Basel-Shokha/Battery-Constrained-Maze-Runner/main.cpp

// ============================================================
//  main.cpp — High-Performance C++ Server Routing Backbone
// ============================================================
#include <iostream>
#include <fstream>
#include <string>
#include <sstream>
#include <set>
#include <thread>
#include <mutex>
#include "External Libraries/httplib.h"
#include "MazeSolver.h"

#ifdef _WIN32
  #include <winsock2.h>
  #include <ws2tcpip.h>
  #pragma comment(lib, "ws2_32.lib")
#else
  #include <sys/socket.h>
  #include <netinet/in.h>
  #include <arpa/inet.h>
  #include <unistd.h>
#endif

using nlohmann::json;
using namespace std;

std::string rawM5InstructionString = "START:1,0,0,8\n";
std::string latestMazeJson = "{}";
json globalTelemetryCache = {{"stepIdx",0},{"yaw",0.0},{"left",0},{"front",0},{"right",0},{"state","IDLE"}};
bool newMissionAvailable = false;
bool calibrationRequested = false;
bool resetRequested = false;
mutex telemetryMutex;

void printM5Packet(const std::string& packet) {
    std::cout << "\n========== PACKET SENT TO M5 ==========\n"
              << packet;
    if (packet.empty() || packet.back() != '\n') {
        std::cout << '\n';
    }
    std::cout << "=======================================\n" << std::flush;
}

void removeStartJourneyCommands() {
    std::stringstream input(rawM5InstructionString);
    std::stringstream output;
    std::string line;
    while (std::getline(input, line)) {
        if (line != "CMD:START_JOURNEY" && line != "CMD:ROUTE_ERROR") {
            output << line << "\n";
        }
    }
    rawM5InstructionString = output.str();
}

std::string getHeadingLabel(int dir) {
    if (dir == 0) return "NORTH";
    if (dir == 1) return "EAST";
    if (dir == 2) return "SOUTH";
    if (dir == 3) return "WEST";
    return "UNKNOWN";
}

int countOpenGrids(int startR, int startC, int direction, int maxRows, int maxCols, const json& wallsJson) {
    int openGrids = 0;
    int currR = startR; int currC = startC;
    auto hasWall = [&](int r1, int c1, int r2, int c2) {
        for (const auto& w : wallsJson) {
            if (!w.contains("between") || w["between"].size() < 2) continue;
            int cell1R = w["between"][0][0].get<int>();
            int cell1C = w["between"][0][1].get<int>();
            int cell2R = w["between"][1][0].get<int>();
            int cell2C = w["between"][1][1].get<int>();
            if (((cell1R == r1 && cell1C == c1) && (cell2R == r2 && cell2C == c2)) ||
                ((cell1R == r2 && cell1C == c2) && (cell2R == r1 && cell2C == c1))) {
                return true;
            }
        }
        return false;
    };
    while (true) {
        int nextR = currR; int nextC = currC;
        if      (direction == 0) nextR--;
        else if (direction == 1) nextC++;
        else if (direction == 2) nextR++;
        else if (direction == 3) nextC--;
        if (nextR < 0 || nextR >= maxRows || nextC < 0 || nextC >= maxCols) break;
        if (hasWall(currR, currC, nextR, nextC)) break;
        openGrids++;
        currR = nextR; currC = nextC;
    }
    return openGrids;
}

void udpTelemetryListener() {
#ifdef _WIN32
    WSADATA wsa;
    WSAStartup(MAKEWORD(2, 2), &wsa);
#endif
    int sock = socket(AF_INET, SOCK_DGRAM, 0);
    if (sock < 0) { cerr << "[UDP] socket creation failed\n"; return; }

    sockaddr_in addr{};
    addr.sin_family      = AF_INET;
    addr.sin_addr.s_addr = INADDR_ANY;
    addr.sin_port        = htons(8086);

    if (::bind(sock, (sockaddr*)&addr, sizeof(addr)) < 0) {
        cerr << "[UDP] bind failed on port 8086\n"; return;
    }
    cout << "[UDP] Telemetry listener bound on port 8086\n";

    char buffer[512];
    while (true) {
        int len = recvfrom(sock, buffer, sizeof(buffer) - 1, 0, nullptr, nullptr);
        if (len <= 0) continue;
        buffer[len] = '\0';
        try {
            json data = json::parse(buffer);
            lock_guard<mutex> lock(telemetryMutex);
            globalTelemetryCache["stepIdx"] = data["stepIdx"];
            globalTelemetryCache["yaw"]     = data["yaw"];
            globalTelemetryCache["left"]    = data["left"];
            globalTelemetryCache["front"]   = data["front"];
            globalTelemetryCache["right"]   = data["right"];
            globalTelemetryCache["state"]   = data["state"];
        } catch (...) {
            // malformed datagram, ignore and wait for the next one
        }
    }
}

int main() {
    httplib::Server svr;
    auto add_cors_headers = [](httplib::Response& res) {
        res.set_header("Access-Control-Allow-Origin",  "*");
        res.set_header("Access-Control-Allow-Methods", "POST, GET, OPTIONS");
        res.set_header("Access-Control-Allow-Headers", "Content-Type");
    };

    svr.Options("/send_maze",     [&](const httplib::Request&, httplib::Response& res) { add_cors_headers(res); res.status = 204; });
    svr.Options("/start_journey", [&](const httplib::Request&, httplib::Response& res) { add_cors_headers(res); res.status = 204; });
    svr.Options("/reset",         [&](const httplib::Request&, httplib::Response& res) { add_cors_headers(res); res.status = 204; });
    svr.Options("/notify_event",  [&](const httplib::Request&, httplib::Response& res) { add_cors_headers(res); res.status = 204; });
    svr.Options("/get_telemetry", [&](const httplib::Request&, httplib::Response& res) { add_cors_headers(res); res.status = 204; });
    svr.Options("/solve",         [&](const httplib::Request&, httplib::Response& res) { add_cors_headers(res); res.status = 204; });

    // ── ROUTE A: RECEIVE & BUILD STRUCT SOLUTION ────────────────────
    svr.Post("/send_maze", [&](const httplib::Request& req, httplib::Response& res) {
        add_cors_headers(res);
        try {
            json request = json::parse(req.body);
            std::string spawnDirStr = request["robot_direction"].get<std::string>();
            int initialSpawnDirectionInt = 1;
            if      (spawnDirStr == "north") initialSpawnDirectionInt = 0;
            else if (spawnDirStr == "south") initialSpawnDirectionInt = 2;
            else if (spawnDirStr == "west")  initialSpawnDirectionInt = 3;

            long long cap = request["config"]["battery_capacity"].get<long long>();
            int modeCode = 0; // 0 = CONSTRAINED, 1 = CONTINUOUS

            if (cap > 1000000) {
                modeCode = 1;
                cap = 8;
            }

            json path = json::array();

            // ── MANUAL ROUTE: follow the exact cells from the web UI, no solving ──
            if (request.contains("use_manual_route") && request["use_manual_route"].get<bool>()
                && request.contains("manual_route") && request["manual_route"].size() >= 2) {

                json route = request["manual_route"];
                for (int k = 0; k < route.size(); k++) {
                    json leg;
                    leg["cell"] = { route[k][0].get<int>(), route[k][1].get<int>() };
                    if      (k == 0)                leg["type"] = "start";
                    else if (k == route.size() - 1) leg["type"] = "destination";
                    else                            leg["type"] = "move";
                    path.push_back(leg);
                }
            } else {
                // ── NORMAL: solve the maze as before ──
                MazeSolver solver(request); json solution; solver.dumpSolution(solution);

                if (solution["feasible"].get<bool>() == false) {
                    rawM5InstructionString = "CMD:ROUTE_ERROR\n";
                    newMissionAvailable = true; 
                    res.set_content("{\"status\":\"stored\",\"feasible\":false}", "application/json");
                    return;
                }
                path = solution["path"];
            }

            int totalNodes = path.size();
            int rows = request["config"]["rows"].get<int>();
            int cols = request["config"]["columns"].get<int>();
            json wallsJson = request["walls"];

            std::stringstream textStream;
            int totalCompressedSteps = 0;
            std::stringstream stepBuffer;

            int i = 0;
            while (i < totalNodes - 1) {
                int currR = path[i]["cell"][0].get<int>();
                int currC = path[i]["cell"][1].get<int>();
                int nextR = path[i+1]["cell"][0].get<int>();
                int nextC = path[i+1]["cell"][1].get<int>();
                int activeHeading = 1;
                if      (nextR < currR) activeHeading = 0;
                else if (nextR > currR) activeHeading = 2;
                else if (nextC > currC) activeHeading = 1;
                else if (nextC < currC) activeHeading = 3;
                int gridsCount = 0; int j = i; int actionCode = 0;
                while (j < totalNodes - 1) {
                    int rA = path[j]["cell"][0].get<int>(); int cA = path[j]["cell"][1].get<int>();
                    int rB = path[j+1]["cell"][0].get<int>(); int cB = path[j+1]["cell"][1].get<int>();
                    int checkHeading = 1;
                    if      (rB < rA) checkHeading = 0;
                    else if (rB > rA) checkHeading = 2;
                    else if (cB > cA) checkHeading = 1;
                    else if (cB < cA) checkHeading = 3;
                    if (checkHeading == activeHeading) {
                        gridsCount++; j++;
                        if (path[j]["type"].get<std::string>() == "charge") {
                            actionCode = 1; break;
                        }
                    } else break;
                }
                int targetIntersectionR = path[j]["cell"][0].get<int>();
                int targetIntersectionC = path[j]["cell"][1].get<int>();
                int totalOpenGridsAhead = countOpenGrids(currR, currC, activeHeading, rows, cols, wallsJson);
                int stopLimitRemainingGrids = countOpenGrids(targetIntersectionR, targetIntersectionC, activeHeading, rows, cols, wallsJson);
                stepBuffer << "STEP:" << totalCompressedSteps << "," << activeHeading << ","
                           << gridsCount << "," << totalOpenGridsAhead << "," << stopLimitRemainingGrids << "," << actionCode << "\n";
                totalCompressedSteps++;
                i = j;
            }

            textStream << "START:" << initialSpawnDirectionInt << "," << totalCompressedSteps << "," << modeCode << "," << cap << "\n";
            textStream << stepBuffer.str();

            rawM5InstructionString = textStream.str();
            latestMazeJson = request.dump();
            newMissionAvailable = false;
            resetRequested = false;
            res.set_content("{\"status\":\"stored\",\"feasible\":true}", "application/json");
        } catch (...) {
            res.status = 400; res.set_content("{\"status\":\"error\"}", "application/json");
        }
    });

    svr.Post("/calibrate", [&](const httplib::Request&, httplib::Response& res) {
        add_cors_headers(res);
        calibrationRequested = true;
        std::cout << "[SERVER] Calibration requested by web UI.\n";
        res.set_content("{\"status\":\"calibration_queued\"}", "application/json");
    });

    svr.Get("/get_calibrate", [&](const httplib::Request&, httplib::Response& res) {
        add_cors_headers(res);
        if (calibrationRequested) {
            calibrationRequested = false;
            res.set_content("{\"calibrate\":true}", "application/json");
        } else {
            res.set_content("{\"calibrate\":false}", "application/json");
        }
    });

    svr.Post("/reset", [&](const httplib::Request&, httplib::Response& res) {
        add_cors_headers(res);
        resetRequested = true;
        calibrationRequested = false;
        newMissionAvailable = false;
        removeStartJourneyCommands();
        globalTelemetryCache["stepIdx"] = -1;
        globalTelemetryCache["yaw"]     = 0.0;
        globalTelemetryCache["left"]    = 0;
        globalTelemetryCache["front"]   = 0;
        globalTelemetryCache["right"]   = 0;
        globalTelemetryCache["state"]   = "RESETTING";
        std::cout << "[SERVER] Reset requested by web UI.\n";
        res.set_content("{\"status\":\"reset_queued\"}", "application/json");
    });

    svr.Get("/get_reset", [&](const httplib::Request&, httplib::Response& res) {
        add_cors_headers(res);
        if (resetRequested) {
            resetRequested = false;
            res.set_content("{\"reset\":true}", "application/json");
        } else {
            res.set_content("{\"reset\":false}", "application/json");
        }
    });

    svr.Post("/start_journey", [&](const httplib::Request& req, httplib::Response& res) {
        add_cors_headers(res);
        removeStartJourneyCommands();
        rawM5InstructionString += "CMD:START_JOURNEY\n";
        newMissionAvailable = true;
        std::cout << "[SERVER HANDSHAKE] Start command logged. Sending execution cue to M5!\n";
        res.set_content("{\"status\":\"started\"}", "application/json");
    });

    svr.Get("/get_instructions", [&](const httplib::Request&, httplib::Response& res) {
        res.set_content(rawM5InstructionString, "text/plain");
        if (newMissionAvailable) {
            printM5Packet(rawM5InstructionString);
            std::cout << "[WIFI LINK] M5 Stick fetched solution array. Running now.\n";
            newMissionAvailable = false;
        }
    });

    svr.Get("/get_maze", [&](const httplib::Request&, httplib::Response& res) {
        res.set_content(latestMazeJson, "application/json");
    });

    svr.Post("/update_telemetry", [&](const httplib::Request& req, httplib::Response& res) {
        try {
            json data = json::parse(req.body);
            globalTelemetryCache["stepIdx"] = data["stepIdx"];
            globalTelemetryCache["yaw"]     = data["yaw"];
            globalTelemetryCache["left"]    = data["left"];
            globalTelemetryCache["front"]   = data["front"];
            globalTelemetryCache["right"]   = data["right"];
            globalTelemetryCache["state"]   = data["state"];
            res.status = 200; res.set_content("{\"status\":\"ok\"}", "application/json");
        } catch(...) {
            res.status = 400; res.set_content("{\"status\":\"error\"}", "application/json");
        }
    });

    svr.Post("/notify_event", [&](const httplib::Request& req, httplib::Response& res) {
        add_cors_headers(res);
        try {
            json event = json::parse(req.body);
            std::string eventName = event.value("event", "UNKNOWN");
            int eventValue = event.value("value", 0);
            if (eventName == "RUN_RESET_ACK") {
                globalTelemetryCache["stepIdx"] = -1;
                globalTelemetryCache["state"] = "IDLE";
            }
            std::cout << "[M5 EVENT] " << eventName << " value=" << eventValue << "\n";
            res.set_content("{\"status\":\"ok\"}", "application/json");
        } catch (...) {
            res.status = 400; res.set_content("{\"status\":\"error\"}", "application/json");
        }
    });

    svr.Get("/get_telemetry", [&](const httplib::Request&, httplib::Response& res) {
        add_cors_headers(res);
        lock_guard<mutex> lock(telemetryMutex);
        res.set_content(globalTelemetryCache.dump(), "application/json");
    });

    svr.Post("/solve", [&](const httplib::Request& req, httplib::Response& res) {
        add_cors_headers(res);
        try {
            json request = json::parse(req.body);
            MazeSolver solver(request); json response; solver.dumpSolution(response);
            res.set_content(response.dump(4), "application/json");
        } catch (const std::exception& e) {
            json err; err["feasible"] = false; err["message"] = e.what();
            res.status = 500; res.set_content(err.dump(), "application/json");
        }
    });

    svr.Get("/", [](const httplib::Request&, httplib::Response& res) {
        std::ifstream f("index.html");
        std::string html((std::istreambuf_iterator<char>(f)), std::istreambuf_iterator<char>());
        res.set_content(html, "text/html");
    });

     thread(udpTelemetryListener).detach();
     std::cout << "Wireless local server listening at http://0.0.0.0:8085\n";
     svr.listen("0.0.0.0", 8085);
    return 0;
}
