Basel-Shokha/Battery-Constrained-Maze-Runner/ESP32/ESP32.ino

#include "PROTOCOL.h"
#include <Adafruit_NeoPixel.h>

#define TOTAL_NUM_PIXELS 16

HardwareSerial M5Serial(2);
uint16_t distLeft = 0, distFront = 0, distRight = 0;
unsigned long lastSendTime = 0;

unsigned long lastOrangeUpdateTime = 0;
unsigned long notifyResendTime      = 0;
bool isAwaitingChargeDoneAck        = false;

String inputBuffer = "";


bool continuousWhiteMode       = false;
bool batteryIndicatorActive    = false;
int currentGreenLedsCount      = 0;

extern void initLED();
extern void clearRing();
extern void setRingColor(uint8_t r, uint8_t g, uint8_t b);
extern void setSinglePixel(uint8_t index, uint8_t r, uint8_t g, uint8_t b);

extern void initMP3();
extern void setVolume(uint8_t volume);
extern void playTrack(uint8_t directory, uint8_t trackNumber);
extern bool resetMP3();

extern void initSensors();
extern void readSensors();
extern void runRechargingMode();

void parsePacket(String inLine);
void updateOrangeBreathing(unsigned long now);

void setup() {
    Serial.begin(115200);
    initLED(); 
    initMP3();
    initSensors(); 

    setVolume(30);
    setRingColor(200, 60, 0);
    lastOrangeUpdateTime = millis();
    M5Serial.begin(115200, SERIAL_8N1, 16, 17);
}

void loop() {
    unsigned long now = millis();
    if (isAwaitingChargeDoneAck) {
        if (now - notifyResendTime >= 100) { 
            notifyResendTime = now;
            M5Serial.println("NOTIFY:CHARGE_DONE");
        }
    } 
    
    else if (continuousWhiteMode) {
        setRingColor(150, 150, 150);
    }
    
    else if (batteryIndicatorActive) {
        clearRing();
        for (int i = 0; i < currentGreenLedsCount; i++) {
            setSinglePixel(i, 0, 150, 0);
        }
    }
    else {
        updateOrangeBreathing(now);
    }

    readSensors();
    if (now - lastSendTime >= 60) {
        lastSendTime = now;
        M5Serial.printf("DIST:%d,%d,%d\n", distLeft, distFront, distRight);
    }

    while (M5Serial.available() > 0) {
        char c = M5Serial.read();
        if (c == '\n') {
            inputBuffer.trim();
            if (inputBuffer == "ACK:CHARGE_DONE") {
                isAwaitingChargeDoneAck = false;
                lastOrangeUpdateTime = millis(); 
            } else if (inputBuffer.length() > 0) {
                parsePacket(inputBuffer);
            }
            inputBuffer = "";
        } else if (c != '\r') {
            inputBuffer += c;
        }
    }
}

void updateOrangeBreathing(unsigned long now) {
    if (now - lastOrangeUpdateTime >= 20) {
        lastOrangeUpdateTime = now;
        float angle = (float)(now % 5000) * (2.0f * M_PI / 5000.0f);
        float factor = (sinf(angle) + 1.0f) / 2.0f;
        uint8_t redValue   = 50 + (uint8_t)(factor * 150.0f);
        uint8_t greenValue = 20 + (uint8_t)(factor * 60.0f);
        setRingColor(redValue, greenValue, 0);
    }
}

void parsePacket(String inLine) {
    if (!inLine.startsWith("PACKET:")) return;
    int cmdId = 0, p1 = 0, p2 = 0;
    if (sscanf(inLine.c_str(), "PACKET:%d,%d,%d", &cmdId, &p1, &p2) != 3) return;
    
    if (cmdId == CMD_PLAY_AUDIO) {
        setVolume(30);
        delay(10);
        int trackNumber = p1 - 100;
        if (trackNumber >= 1 && trackNumber <= 5) {
            playTrack(1, trackNumber);
        }
    }
    else if (cmdId == CMD_STOP_AUDIO) {
        resetMP3();
    }
    else if (cmdId == CMD_START_CHARGE) {
        M5Serial.println("ACK:3");
        runRechargingMode();
        isAwaitingChargeDoneAck = true;
        notifyResendTime = 0;
    }
    
    else if (cmdId == CMD_BATTERY_UPDATE) {
        if (p1 == 255 && p2 == 255) {
            continuousWhiteMode    = true;
            batteryIndicatorActive = false;
            setRingColor(150, 150, 150); 
        } 
        else if (p1 == 0 && p2 == 0) {
            continuousWhiteMode    = false;
            batteryIndicatorActive = false;
            lastOrangeUpdateTime   = millis(); 
        }
        else if (p2 > 0) {
            continuousWhiteMode    = false;
            batteryIndicatorActive = true;
            currentGreenLedsCount  = (p1 * TOTAL_NUM_PIXELS) / p2;
            currentGreenLedsCount  = constrain(currentGreenLedsCount, 0, TOTAL_NUM_PIXELS);
            clearRing();
            for (int i = 0; i < currentGreenLedsCount; i++) {
                setSinglePixel(i, 0, 150, 0);
            }
        }
    }
}
