Basel-Shokha/Battery-Constrained-Maze-Runner/(commit log)

2026-04-16 Initial commit: Imported base layout for Battery-Constrained Maze Runner
2026-05-24 updating message to "energy units" instead of "battery units"
2026-06-15 adding the two sensor test
2026-07-01 feat(hardware): create modular LED ring driver abstraction for ESP32
2026-07-01 config(esp32): lock down native pin mappings with LED ring on D13
2026-07-01 fix(backend): correct server endpoint routing scope inside main block
    [main.cpp]
2026-07-02 fix(backend): clean syntax tracking and fix listener binding to port 8085
    [main.cpp]
2026-07-05 Add files via upload
    Gyroscope interface.
2026-07-06 adding the packet printing to the main
2026-07-06 adding the sensor to be 15 instead of 27 , everything(maybe) works fine unless the m5 file
2026-07-07 adding the reset button and changing relavent files
2026-07-07 updating sensors.ino
2026-07-07 working gyro video 18:48
2026-07-08 not verified, but even led logic working
2026-07-08 led + path draw logic integration - not verified
2026-07-09 fixing a minor error in the main
    [main.cpp]
2026-07-09 adding the sensor sending to the PC
2026-07-09 first try telemetry and failed ( not seeing it on the screen but i can see the sensors reading
2026-07-13 note : changed theshold to 7.5cm instead of 5cm too
2026-07-18 solving the rouble recharging animation problem
    [ESP32.ino]
2026-07-20 update PROTOCOL + fixing the prameters
    [PROTOCOL.h, parameters.h]
2026-07-20 update sensors + recharging
2026-07-20 update mp3+led
2026-07-21 update gyroscope
2026-07-21 update battery_engine
